suyashsrivastava-ee/Kiki-Health-Companion/submission/DEMO.md

# 🎬 Project Demo

[✨ Project Demo Video](https://www.youtube.com/watch?v=SXq7fLjbRYM)

---

### 📺 Video Preview
Click the image below to watch the full demonstration on YouTube:

Project Demo Video (https://www.youtube.com/watch?v=SXq7fLjbRYM)

---

### 📊 Presentation

The SIH idea submission deck is in [PRESENTATION.md](PRESENTATION.md) — [PDF in this repo](./SIH26181_Team_The KikiCrew_Presentation.pdf) or [on Google Drive](https://drive.google.com/file/d/19Gz7P0E8064CH7wUCHbpV1ZqjmQZaEzY/view).

---
