suyashsrivastava-ee/Kiki-Health-Companion/(notices)

Notices in the files:
README.md:
License: MIT
